AlexGyver/GyverSaber/schemes/btn.jpg

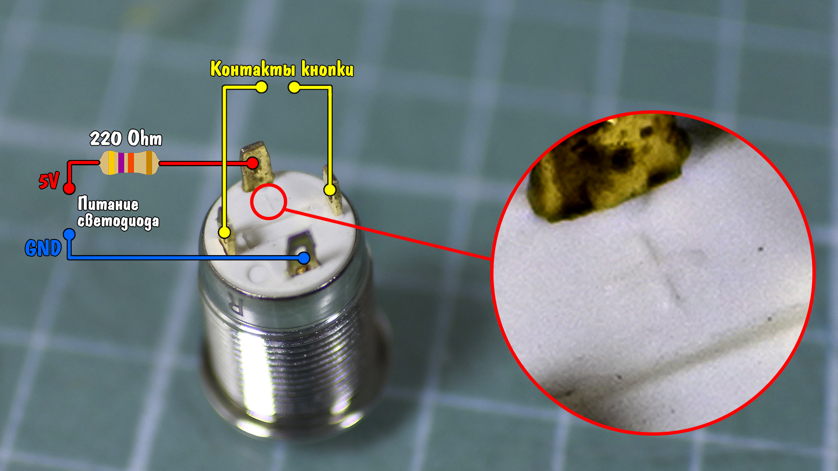
schemes/btn.jpg
