AlexGyver/GyverSaber/schemes/scheme3.jpg

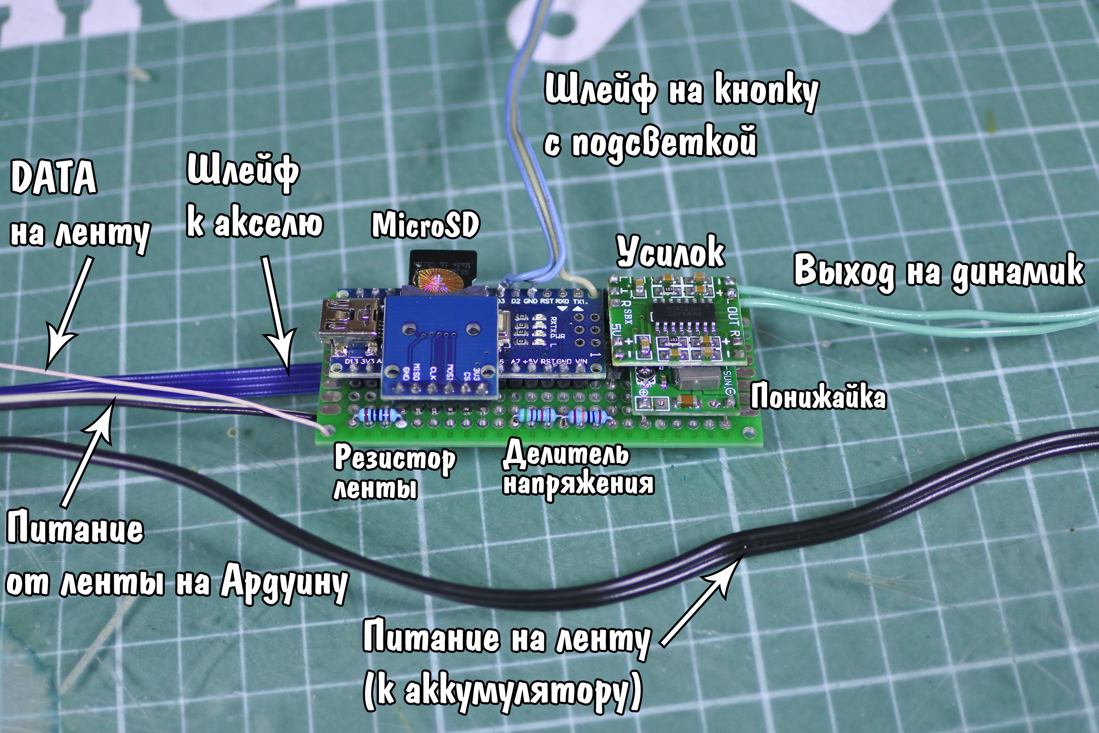
schemes/scheme3.jpg
