AlexGyver/GyverSaber/(threads)

Thread 2 (2018-02-08):

Вопрос про усложненную схему при подключениии модуля к аккумуляторам

25EvgeN25, 2018-02-08:
Здравствуйте Алекс! Вы на видео на 4:55 минуте говорите , что модуль усложняет схему. Можете показать как именно?

Nailka007, 2018-04-18:
Элементарно, смотрим видос про акб у автора

Thread 3 (2018-02-20):

Алгоритм аккумулятора

Sergey3057, 2018-02-20:
Добрый день!
По проекту - световой меч.
Использую 2 банки 18650, получаю измеренное U=8,36v. Лента на 5 вольт. Схема работает не стабильно. Огромное влияние оказывают номиналы резисторов делителя. При отключении батареи, при снижении заряда до 51% меч не включается. Схему питаю от 2 банок акб напрямую, ленту от  LT1083-5v, CD и MPU6050 ардуино нано 3,3в. Усилитель свой на мс SSM221 1,5W - работает хорошо, запитан от 5в (LT1083). Но! Звуки идут не стабильно, то отлично, то обрывками, то вместо звука - трещотка. CD определилась ОК, Аксель не определился, меняю третий модуль - не определяется. Распайку проверял, всё согласно схемы. VCC=3,3v; GND=A1; SDA=A4; SCL=A5.
 Пробовал играть с номиналами R1 и R2. Картина очень интересная. При увеличении R1 - появляются звуки, но нет переключения цвета ленты. При уменьшении R2 - лента при включении не полностью загорается. Изменяя номиналы, наблюдаю разную картину работы меча.
Собственно вопросы:
1. Как пересчитать Ваш "ох...." алгоритм на две банки? Что изменить в скетче?
2. Как снизить порог не включения меча?
3. Почему всё же не определяется MPU6050? Менял 3 штуки, покупал у разных поставщиков.
4. Как влияют номиналы R1 и R2 на работу схемы? Связано с "ох..." алгоритмом?

Спасибо!

Nailka007, 2018-04-18:
Сложно) собирай по схеме, так проще. А вот на счёт 5в это интересно. Я вот хз как это реализовать, если брать 5в то и ленту соответствующую надо, а значит (возможно) и чип сменится, чип меняем - изменяем код. Сложно, я бы меч Дарта Мола сделал

ashekshuev, 2018-04-30:
1)оставь 3 банки.
2)собирай как на рисунке. с лева распиновка ошибочна. аксель и СД не работают по ней

Sergey3057, 2018-04-30:
Работает от двух банок. Лента на 5 вольт. Все работает, но иногда подглючивает. На стабильность и правильность работы сильно влияют номиналы резисторов делителя. Вот почему нужен перерасчет алгоритма акб на две банки.

Отправлено со смартфона Samsung Galaxy.

-------- Исходное сообщение --------
От: AlexanderSh <notifications@github.com>
Дата:30.04.2018  23:27  (GMT+05:00)
Кому: AlexGyver/GyverSaber <GyverSaber@noreply.github.com>
Копия: Sergey3057 <skn_57@mail.ru>, Author <author@noreply.github.com>
Тема: Re: [AlexGyver/GyverSaber] Алгоритм аккумулятора (#3)

1)оставь 3 банки.
2)собирай как на рисунке. с лева распиновка ошибочна. аксель и СД не работают по ней

—
You are receiving this because you authored the thread.
Reply to this email directly, view it on GitHub, or mute the thread.

Sergey3057, 2018-04-30:
СД работает - модуль "тройка". Аксель - gnd модуля на gnd контролера, тогда все работает.

Отправлено со смартфона Samsung Galaxy.

-------- Исходное сообщение --------
От: AlexanderSh <notifications@github.com>
Дата:30.04.2018  23:27  (GMT+05:00)
Кому: AlexGyver/GyverSaber <GyverSaber@noreply.github.com>
Копия: Sergey3057 <skn_57@mail.ru>, Author <author@noreply.github.com>
Тема: Re: [AlexGyver/GyverSaber] Алгоритм аккумулятора (#3)

1)оставь 3 банки.
2)собирай как на рисунке. с лева распиновка ошибочна. аксель и СД не работают по ней

—
You are receiving this because you authored the thread.
Reply to this email directly, view it on GitHub, or mute the thread.

lmHuman, 2018-05-23:
Без общей gnd можно спалить ардуинку

Thread 4 (2018-03-12):

Сможете помочь что тут в скетче нужно справить?

therekzifrost, 2018-03-12:
In file included from e:\all for arduino\arduino\hardware\tools\avr\avr\include\avr\io.h:272:0,

                 from e:\all for arduino\arduino\hardware\tools\avr\avr\include\avr\pgmspace.h:88,

                 from E:\All for Arduino\arduino\hardware\arduino\avr\cores\arduino/Arduino.h:28,

                 from sketch\GyverSaber.ino.cpp:1:

e:\all for arduino\arduino\hardware\tools\avr\avr\include\avr\iom328p.h:4:2: error: invalid preprocessing directive #Њ

  AЫ Т°¤Д—јd‘]% ф %Ђ`Сncx-Н
Ђеў.ZЩЪfЂTІ

  ^

In file included from e:\all for arduino\arduino\hardware\tools\avr\avr\include\avr\io.h:272:0,

                 from e:\all for arduino\arduino\hardware\tools\avr\avr\include\avr\pgmspace.h:88,

                 from E:\All for Arduino\arduino\hardware\arduino\avr\cores\arduino/Arduino.h:28,

                 from sketch\GyverSaber.ino.cpp:1:

e:\all for arduino\arduino\hardware\tools\avr\avr\include\avr\iom328p.h:132:2: error: invalid preprocessing directive #Њ

exit status 1
Error compiling for board Arduino Nano.

therekzifrost, 2018-03-16:
все проблема решена чего то не хотело прошивать на одном из компьютеров

lmHuman, 2018-05-23:
Пробелы и имена путей больше 8 символов.
